andrenho/fortuna-4/README.md

# Fortuna-4
A Z80-based computer using a Raspberry Pi PICO for I/O.
