andrenho/fortuna-4/TODO.md

# Preparation
- [x] Redo findserial.py (Mac and Linux)
- [x] Write a python library to interact with debugger
- [x] Adapt debugger to the library
- [x] Reorganize source code

# Computer
- [x] Create circuit
- [x] Make changes (add boot)

# I/O board
- [x] I/O using PIO
- [ ] Serial
- [ ] VGA
- [ ] Bank switching
- [ ] SDCard storage

# Documentation
- [ ] Copy documentation over from Fortuna-Box
- [ ] Document boot process
