andrenho/fortuna-4/debugger-web/index.html

## Fortuna Box debugger

Code (1)

Memory (2)

Step (s) Next (n) Run (r) Reset (w) Recompile & Reset (x)

Running...

A | | BC
DE | | HL
IX | | IY
PC | 0000 | SP
AF' | | BC'
DE' | | HL'

S Z H

N C P/V

Stack:

↑↓

Bank:

RAMONLY:

Advanced Show address/opcodes

Single cycle Clear Clear ROM Fill ROM

# | ADDR | DATA | M1 | IORQ | BUSAK | WAIT | INT | WR | RD | MREQ

Page: 0x00

<< >>

| _0 | _1 | _2 | _3 | _4 | _5 | _6 | _7 | _8 | _9 | _A | _B | _C | _D | _E | _F

Run self-test
