andrenho/fortuna-4/circuit/computer.kicad_sch

## KiCad design circuit/computer.kicad_sch (2024-04-25, an earlier design)

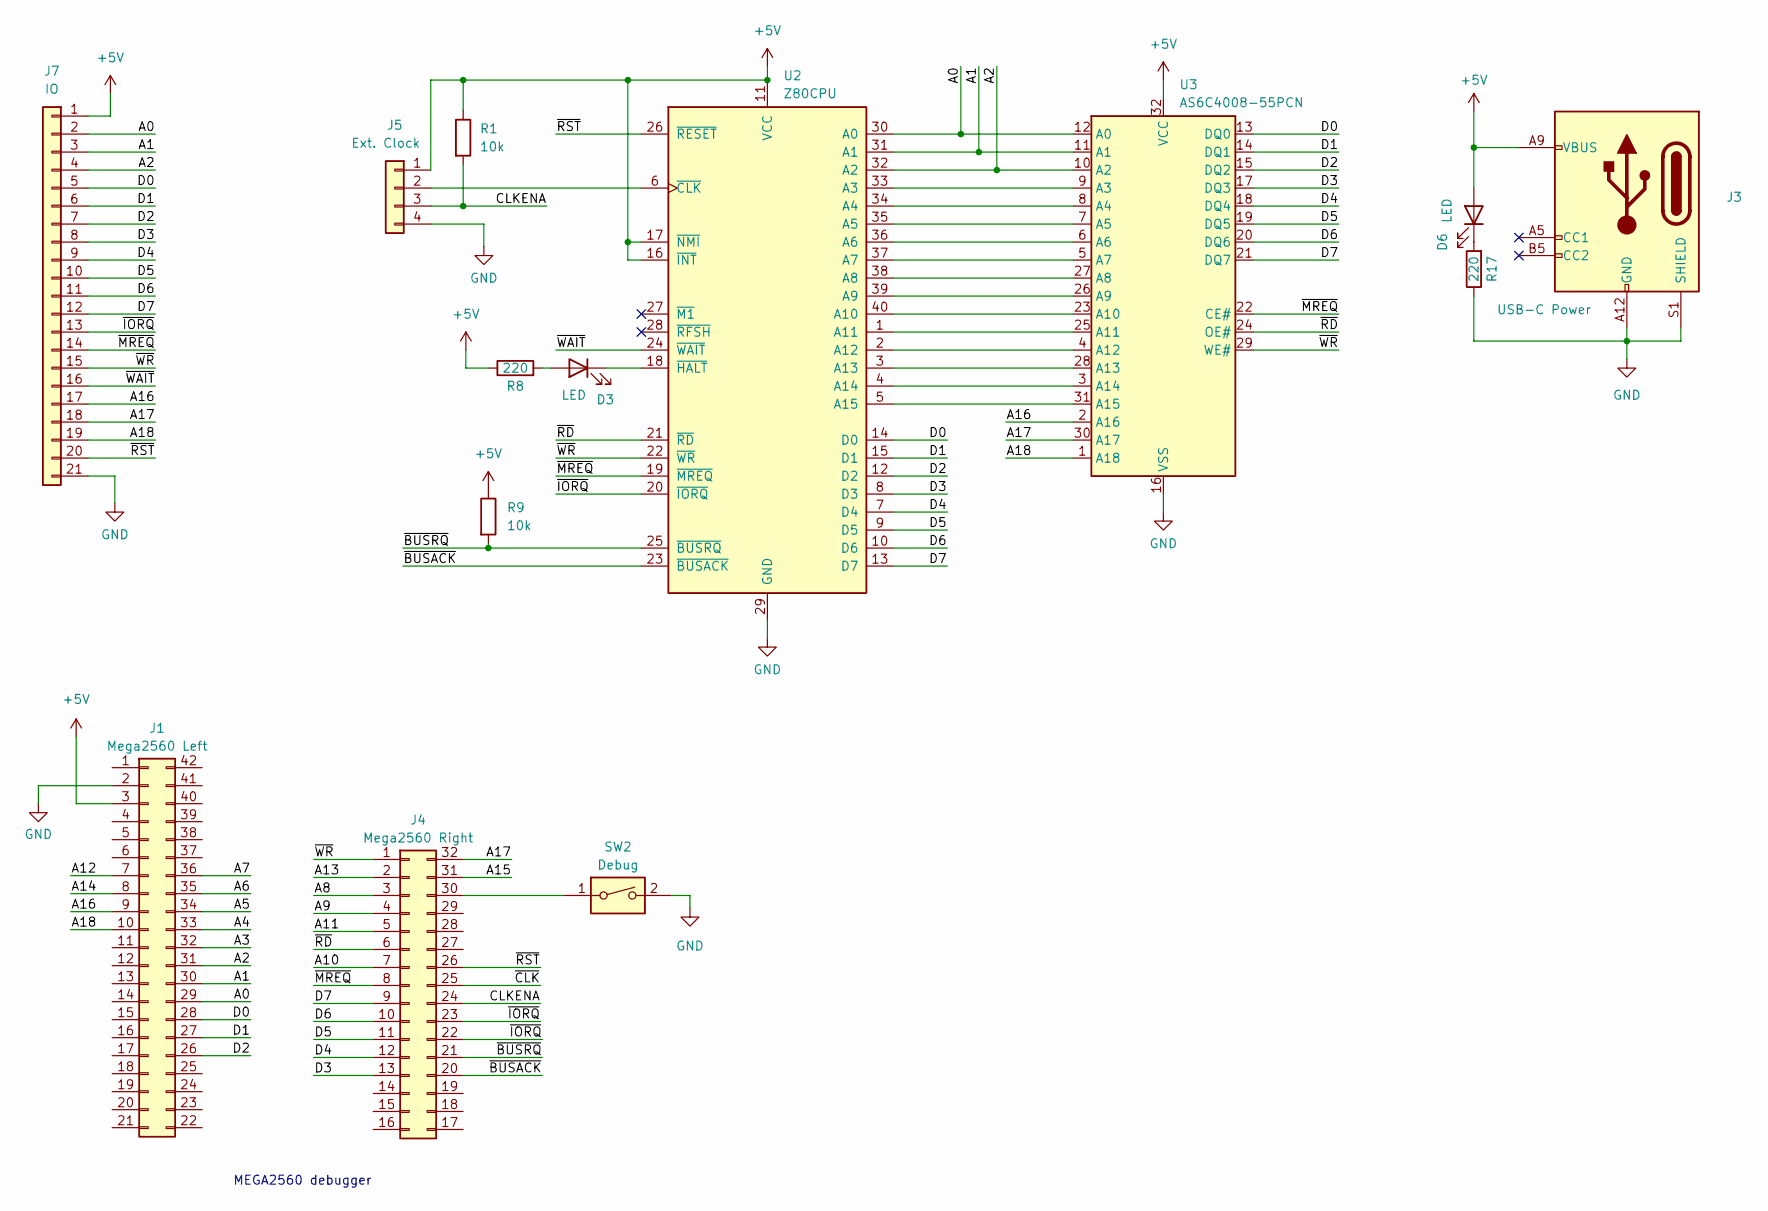
[picture p1: schematic computer.kicad_sch]

Parts:
D3, D6: LED
J1: Mega2560 Left
J3: USB-C Power
J4: Mega2560 Right
J5: Ext. Clock
J7: IO
R1, R9: 10k
R8, R17: 220
SW2: Debug
U2: Z80CPU
U3: AS6C4008-55PCN; DIP-32_W15.24mm

Connections:
+5V: D6.2 (A), J1.3, J3.A9 (VBUS), J3.B9 (VBUS), J5.1, J7.1, R1.1, R8.1, R9.1, U2.11 (VCC), U2.16 (~INT), U2.17 (~NMI), U3.32 (VCC)
A0: J1.29, J7.2, U2.30 (A0), U3.12 (A0)
A1: J1.30, J7.3, U2.31 (A1), U3.11 (A1)
A2: J1.31, J7.4, U2.32 (A2), U3.10 (A2)
A3: J1.32
A4: J1.33
A5: J1.34
A6: J1.35
A7: J1.36
A8: J4.3
A9: J4.4
A10: J4.7
A11: J4.5
A12: J1.7
A13: J4.2
A14: J1.8
A15: J4.31
A16: J1.9, J7.17, U3.2 (A16)
A17: J4.32, J7.18, U3.30 (A17)
A18: J1.10, J7.19, U3.1 (A18)
CLKENA: J4.24, J5.3, R1.2
D0: J1.28, J7.5, U2.14 (D0), U3.13 (DQ0)
D1: J1.27, J7.6, U2.15 (D1), U3.14 (DQ1)
D2: J1.26, J7.7, U2.12 (D2), U3.15 (DQ2)
D3: J4.13, J7.8, U2.8 (D3), U3.17 (DQ3)
D4: J4.12, J7.9, U2.7 (D4), U3.18 (DQ4)
D5: J4.11, J7.10, U2.9 (D5), U3.19 (DQ5)
D6: J4.10, J7.11, U2.10 (D6), U3.20 (DQ6)
D7: J4.9, J7.12, U2.13 (D7), U3.21 (DQ7)
GND: J1.2, J3.A12 (GND), J3.B12 (GND), J3.S1 (SHIELD), J5.4, J7.21, R17.1, SW2.2, U2.29 (GND), U3.16 (VSS)
unnamed: D3.1 (K), U2.18 (~HALT)
unnamed: D3.2 (A), R8.2
unnamed: D6.1 (K), R17.2
unnamed: J4.30, SW2.1
unnamed: J5.2, U2.6 (~CLK)
unnamed: U2.1 (A11), U3.25 (A11)
unnamed: U2.2 (A12), U3.4 (A12)
unnamed: U2.3 (A13), U3.28 (A13)
unnamed: U2.4 (A14), U3.3 (A14)
unnamed: U2.5 (A15), U3.31 (A15)
unnamed: U2.33 (A3), U3.9 (A3)
unnamed: U2.34 (A4), U3.8 (A4)
unnamed: U2.35 (A5), U3.7 (A5)
unnamed: U2.36 (A6), U3.6 (A6)
unnamed: U2.37 (A7), U3.5 (A7)
unnamed: U2.38 (A8), U3.27 (A8)
unnamed: U2.39 (A9), U3.26 (A9)
unnamed: U2.40 (A10), U3.23 (A10)
~BUSACK: J4.20, U2.23 (~BUSACK)
~BUSRQ: J4.21, R9.2, U2.25 (~BUSRQ)
~CLK: J4.25
~IORQ: J4.22, J4.23, J7.13, U2.20 (~IORQ)
~MREQ: J4.8, J7.14, U2.19 (~MREQ), U3.22 (CE#)
~RD: J4.6, U2.21 (~RD), U3.24 (OE#)
~RST: J4.26, J7.20, U2.26 (~RESET)
~WAIT: J7.16, U2.24 (~WAIT)
~WR: J4.1, J7.15, U2.22 (~WR), U3.29 (WE#)

Notes on the sheet:
MEGA2560 debugger
