andrenho/fortuna-4/circuit/io.kicad_sch

## KiCad design circuit/io.kicad_sch (2024-04-25, an earlier design)

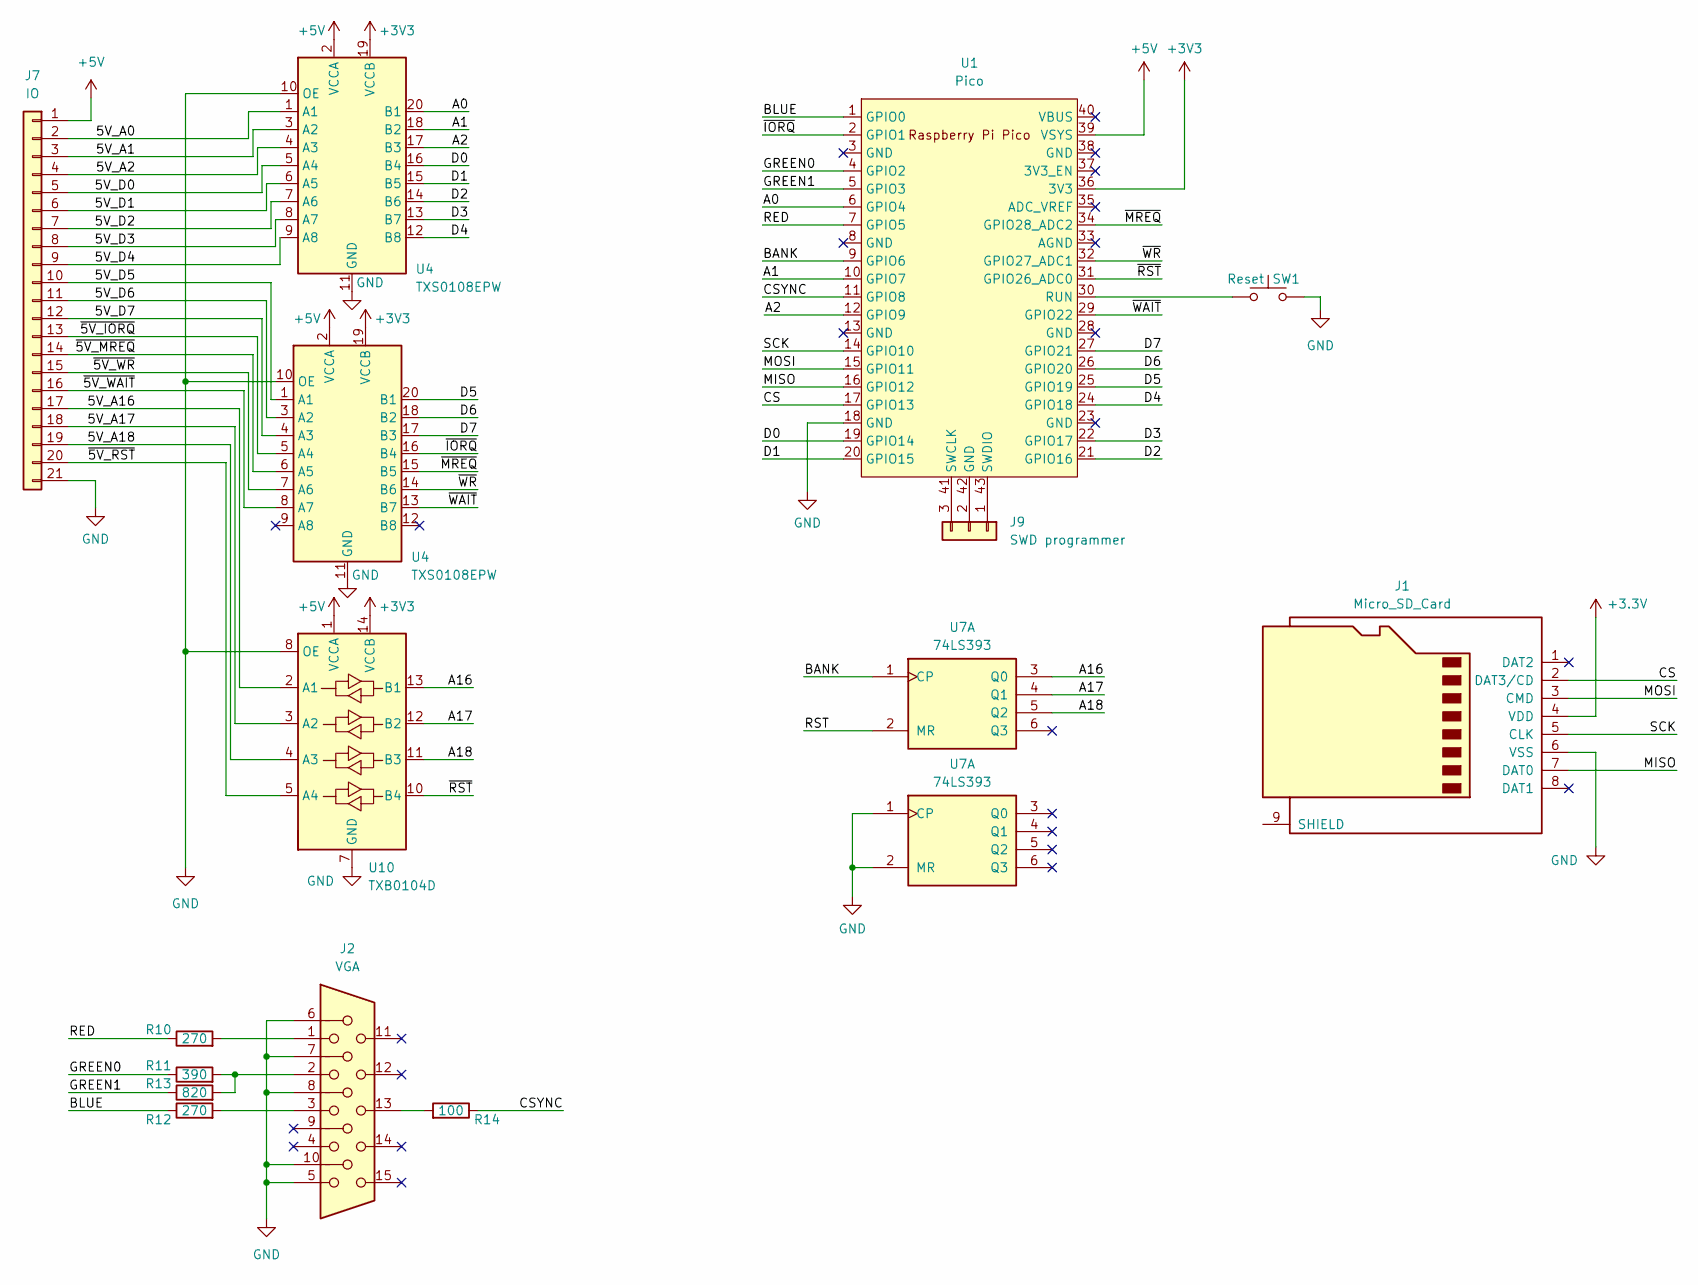
[picture p2: schematic io.kicad_sch]

Parts:
J1: Micro_SD_Card
J2: VGA
J7: IO
J9: SWD programmer
R10, R12: 270
R11: 390
R13: 820
R14: 100
SW1: Reset
U1: Pico; RPi_Pico_SMD_TH
U4: TXS0108EPW; TSSOP-20_4.4x6.5mm_P0.65mm
U7: 74LS393
U10: TXB0104D; SOIC-14_3.9x8.7mm_P1.27mm

Connections:
5V_A0: J7.2, U4.1 (A1)
5V_A1: J7.3, U4.3 (A2)
5V_A2: J7.4, U4.4 (A3)
5V_A16: J7.17, U10.2 (A1)
5V_A17: J7.18, U10.3 (A2)
5V_A18: J7.19, U10.4 (A3)
5V_D0: J7.5, U4.5 (A4)
5V_D1: J7.6, U4.6 (A5)
5V_D2: J7.7, U4.7 (A6)
5V_D3: J7.8, U4.8 (A7)
5V_D4: J7.9, U4.9 (A8)
5V_D5: J7.10, U4.1 (A1)
5V_D6: J7.11, U4.3 (A2)
5V_D7: J7.12, U4.4 (A3)
+3.3V: J1.4 (VDD)
+3V3: U1.36 (3V3), U4.19 (VCCB), U10.14 (VCCB)
+5V: J7.1, U1.39 (VSYS), U4.2 (VCCA), U10.1 (VCCA)
A0: U1.6 (GPIO4), U4.20 (B1)
A1: U1.10 (GPIO7), U4.18 (B2)
A2: U1.12 (GPIO9), U4.17 (B3)
A16: U7.3 (Q0), U10.13 (B1)
A17: U7.4 (Q1), U10.12 (B2)
A18: U7.5 (Q2), U10.11 (B3)
BANK: U1.9 (GPIO6), U7.1 (CP)
BLUE: R12.1, U1.1 (GPIO0)
CS: J1.2 (DAT3/CD), U1.17 (GPIO13)
CSYNC: R14.1, U1.11 (GPIO8)
D0: U1.19 (GPIO14), U4.16 (B4)
D1: U1.20 (GPIO15), U4.15 (B5)
D2: U1.21 (GPIO16), U4.14 (B6)
D3: U1.22 (GPIO17), U4.13 (B7)
D4: U1.24 (GPIO18), U4.12 (B8)
D5: U1.25 (GPIO19), U4.20 (B1)
D6: U1.26 (GPIO20), U4.18 (B2)
D7: U1.27 (GPIO21), U4.17 (B3)
GND: J1.6 (VSS), J2.5, J2.6, J2.7, J2.8, J2.10, J7.21, SW1.2, U1.18 (GND), U4.10 (OE), U4.11 (GND), U7.1 (CP), U7.2 (MR), U10.7 (GND), U10.8 (OE)
GREEN0: R11.1, U1.4 (GPIO2)
GREEN1: R13.1, U1.5 (GPIO3)
MISO: J1.7 (DAT0), U1.16 (GPIO12)
MOSI: J1.3 (CMD), U1.15 (GPIO11)
unnamed: J2.1, R10.2
unnamed: J2.2, R11.2, R13.2
unnamed: J2.3, R12.2
unnamed: J2.13, R14.2
unnamed: J9.1, U1.43 (SWDIO)
unnamed: J9.2, U1.42 (GND)
unnamed: J9.3, U1.41 (SWCLK)
unnamed: SW1.1, U1.30 (RUN)
RED: R10.1, U1.7 (GPIO5)
RST: U7.2 (MR)
SCK: J1.5 (CLK), U1.14 (GPIO10)
~5V_IORQ: J7.13, U4.5 (A4)
~5V_MREQ: J7.14, U4.6 (A5)
~5V_RST: J7.20, U10.5 (A4)
~5V_WAIT: J7.16, U4.8 (A7)
~5V_WR: J7.15, U4.7 (A6)
~IORQ: U1.2 (GPIO1), U4.16 (B4)
~MREQ: U1.34 (GPIO28_ADC2), U4.15 (B5)
~RST: U1.31 (GPIO26_ADC0), U10.10 (B4)
~WAIT: U1.29 (GPIO22), U4.13 (B7)
~WR: U1.32 (GPIO27_ADC1), U4.14 (B6)
