andrenho/fortuna-4/firmware/io/src/serial.cc

#include "serial.hh"

#include "pico/stdlib.h"

#include <cstdio>

namespace serial {

static volatile char last_char = 0x0;

static void input_cb([[maybe_unused]] void* data)
{
    last_char = getchar_timeout_us(0);
}

void init()
{
    stdio_usb_init();
    // stdio_set_chars_available_callback(input_cb, nullptr);
}

uint8_t read()
{
    int current = getchar_timeout_us(0);
    if (current != 0 && current != PICO_ERROR_TIMEOUT) {
        return current;
    }
    return 0;
    /*
    char data = last_char;
    last_char = 0x0;
    return data;
     */
}

void write(uint8_t data)
{
    putchar(data);
}

}
